Mateoswiatek/TME_Electronics_Project/schemat.brd

## EAGLE design schemat.brd (2024-02-10)

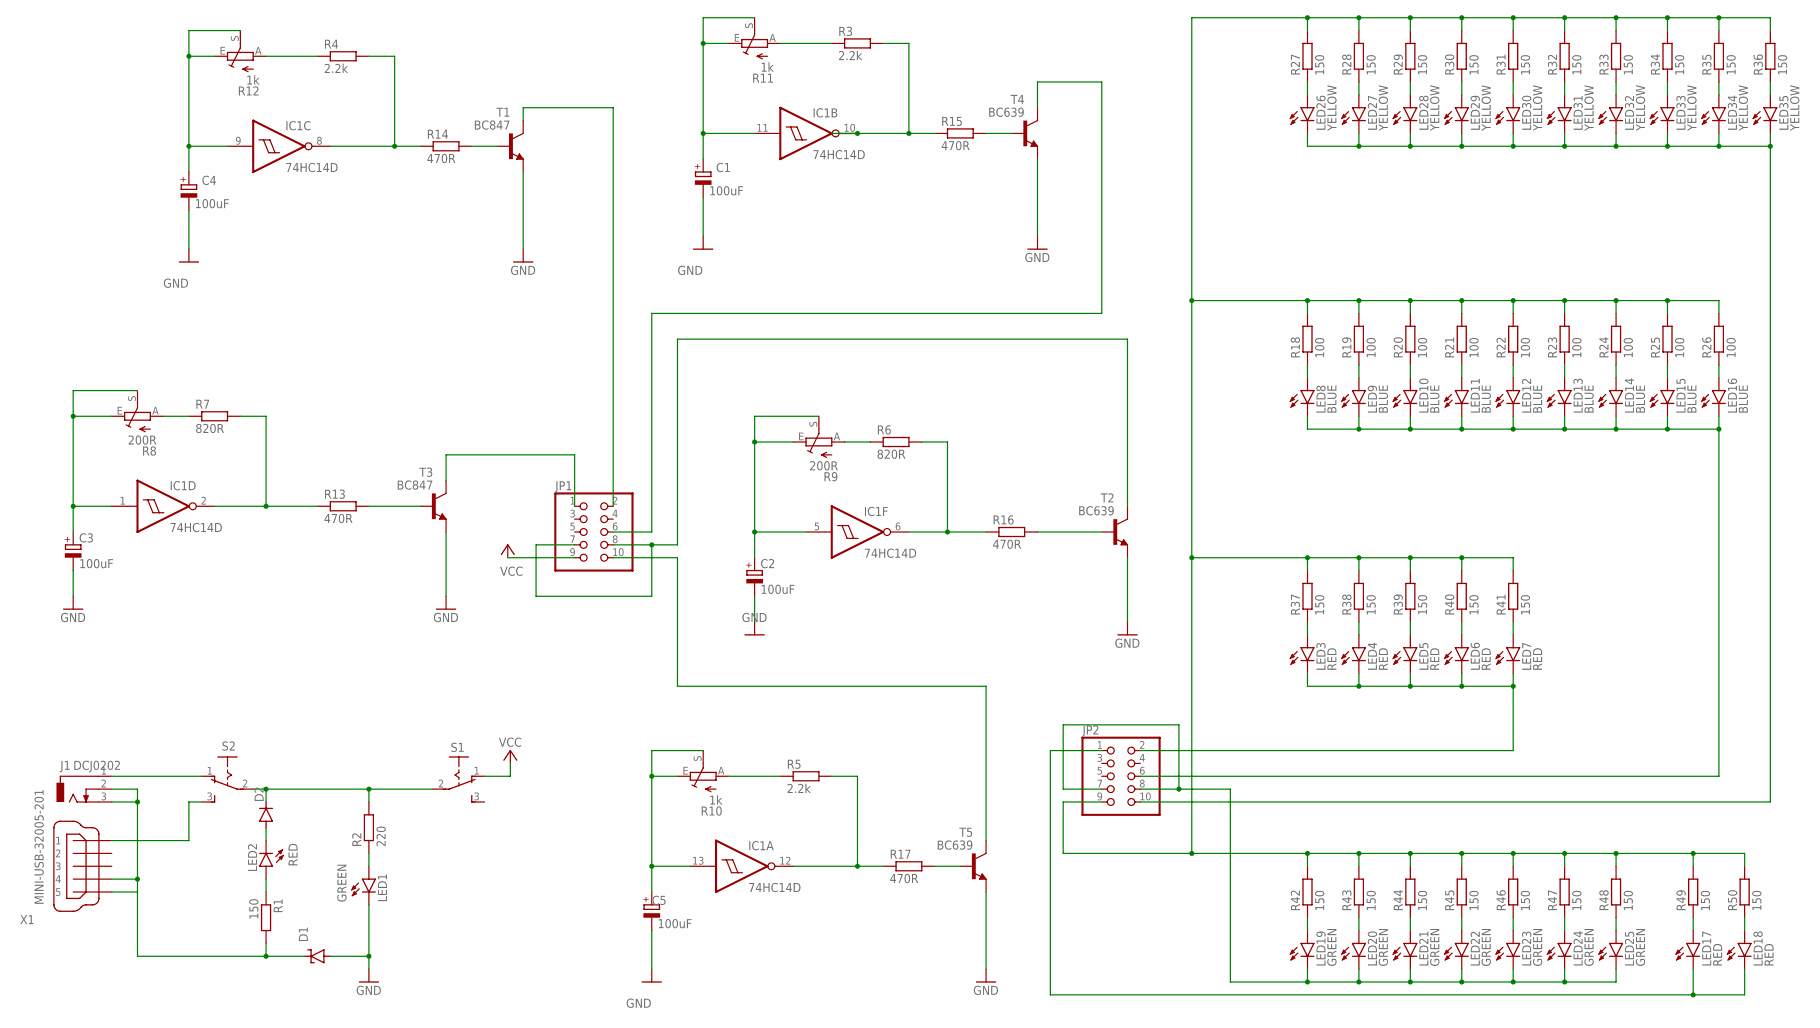
[picture p10: schematic Schemat.sch]

Parts:
C1, C2, C3, C4, C5: 100uF; E2,5-6
D1: SUPPRESSOR-SMBJ; SMBJ
D2: DIODE-DO214AC; DO214AC
IC1: 74HC14D; SO14
J1: DCJ0202
JP1: PINHD-2X5; 2X05
JP2: PINHD-2X5/90; 2X05/90
LED1, LED19, LED20, LED21, LED22, LED23, LED24, LED25: GREEN; LED3MM
LED2, LED3, LED4, LED5, LED6, LED7, LED17, LED18: RED; LED5MM
LED8, LED9, LED10, LED11, LED12, LED13, LED14, LED15, LED16: BLUE; LED5MM
LED26, LED27, LED28, LED29, LED30, LED31, LED32, LED33, LED34, LED35: YELLOW; LED5MM
R1, R27, R28, R29, R30, R31, R32, R33, R34, R35, R36, R37, R38, R39, R40, R41, R42, R43, R44, R45, R46, R47, R48, R49, R50: 150; R0805
R2: 220; R0805
R3, R4, R5: 2.2k; R1206
R6, R7: 820R; R1206
R8, R9: 200R; CA6V
R10, R11, R12: 1k; CA6V
R13, R14, R15, R16, R17: 470R; R1206
R18, R19, R20, R21, R22, R23, R24, R25, R26: 100; R0805
S1, S2: M251
T1, T3: BC847; SOT23
T2, T4, T5: BC639; TO92-ECB
X1: MINI-USB-32005-201; 32005-201

Connections:
GND: C1.-, C2.-, C3.-, C4.-, C5.-, D1.A, IC1.7 (GND), LED1.K (C), T1.2 (E), T2.E, T3.2 (E), T4.E, T5.E
unnamed: JP2.2, LED3.K (C), LED4.K (C), LED5.K (C), LED6.K (C), LED7.K (C)
unnamed: JP2.6, LED8.K (C), LED9.K (C), LED10.K (C), LED11.K (C), LED12.K (C), LED13.K (C), LED14.K (C), LED15.K (C), LED16.K (C)
unnamed: D2.A, LED2.K (C)
unnamed: LED2.A, R1.1
unnamed: JP2.9, R18.2, R19.2, R20.2, R21.2, R22.2, R23.2, R24.2, R25.2, R26.2, R27.2, R28.2, R29.2, R30.2, R31.2, R32.2, R33.2, R34.2, R35.2, R36.2, R37.2, R38.2, R39.2, R40.2, R41.2, R42.2, R43.2, R44.2, R45.2, R46.2, R47.2, R48.2, R49.2, R50.2
unnamed: JP2.10, LED26.K (C), LED27.K (C), LED28.K (C), LED29.K (C), LED30.K (C), LED31.K (C), LED32.K (C), LED33.K (C), LED34.K (C), LED35.K (C)
unnamed: JP2.1, LED17.K (C), LED18.K (C)
unnamed: JP2.7, JP2.8, LED19.K (C), LED20.K (C), LED21.K (C), LED22.K (C), LED23.K (C), LED24.K (C), LED25.K (C)
unnamed: LED3.A, R37.1
unnamed: LED21.A, R44.1
unnamed: LED22.A, R45.1
unnamed: LED23.A, R46.1
unnamed: LED24.A, R47.1
unnamed: LED25.A, R48.1
unnamed: LED19.A, R42.1
unnamed: LED20.A, R43.1
unnamed: LED7.A, R41.1
unnamed: LED6.A, R40.1
unnamed: LED5.A, R39.1
unnamed: LED4.A, R38.1
unnamed: D1.C, J1.2, J1.3, R1.2, X1.4, X1.5
unnamed: LED8.A, R18.1
unnamed: LED9.A, R19.1
unnamed: LED10.A, R20.1
unnamed: LED11.A, R21.1
unnamed: LED12.A, R22.1
unnamed: LED13.A, R23.1
unnamed: LED14.A, R24.1
unnamed: LED15.A, R25.1
unnamed: LED16.A, R26.1
unnamed: JP1.2, T1.3 (C)
unnamed: LED18.A, R50.1
unnamed: LED17.A, R49.1
unnamed: D2.C, R2.2, S1.2, S2.2
unnamed: LED27.A, R28.1
unnamed: LED28.A, R29.1
unnamed: LED29.A, R30.1
unnamed: LED30.A, R31.1
unnamed: LED31.A, R32.1
unnamed: LED32.A, R33.1
unnamed: LED33.A, R34.1
unnamed: LED34.A, R35.1
unnamed: LED35.A, R36.1
unnamed: LED26.A, R27.1
unnamed: C1.+, IC1.11 (I), R11.E, R11.S
unnamed: R3.1, R11.A
unnamed: C4.+, IC1.9 (I), R12.E, R12.S
unnamed: R15.2, T4.B
unnamed: IC1.10 (O), R3.2, R15.1
unnamed: R4.1, R12.A
unnamed: R14.2, T1.1 (B)
unnamed: IC1.8 (O), R4.2, R14.1
unnamed: C5.+, IC1.13 (I), R10.E, R10.S
unnamed: R5.1, R10.A
unnamed: R17.2, T5.B
unnamed: IC1.12 (O), R5.2, R17.1
unnamed: R6.1, R9.A
unnamed: R7.1, R8.A
unnamed: IC1.2 (O), R7.2, R13.1
unnamed: R13.2, T3.1 (B)
unnamed: C3.+, IC1.1 (I), R8.E, R8.S
unnamed: IC1.6 (O), R6.2, R16.1
unnamed: R16.2, T2.B
unnamed: C2.+, IC1.5 (I), R9.E, R9.S
unnamed: LED1.A, R2.1
unnamed: JP1.10, T5.C
unnamed: J1.1, S2.1 (O)
unnamed: S2.3 (S), X1.1
unnamed: JP1.6, T4.C
unnamed: JP1.1, T3.3 (C)
unnamed: JP1.7, JP1.8, T2.C
VCC: IC1.14 (VCC), JP1.9, S1.1 (O)

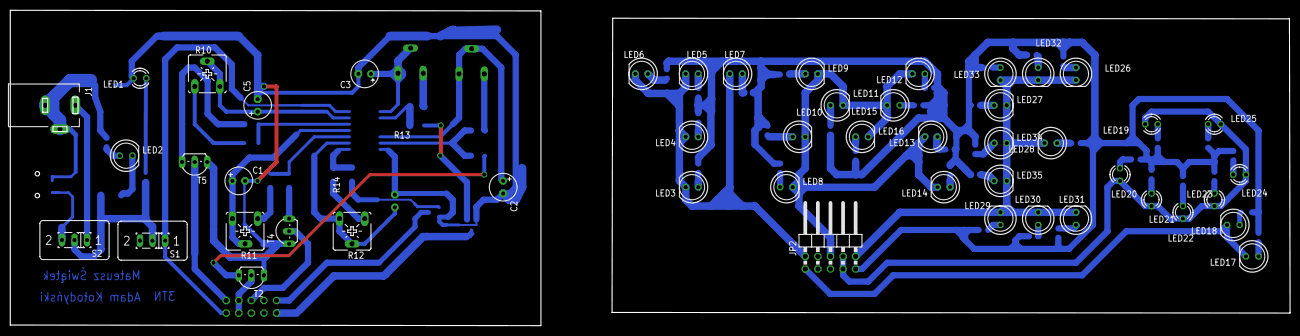
[picture p11: board schemat.brd from above]

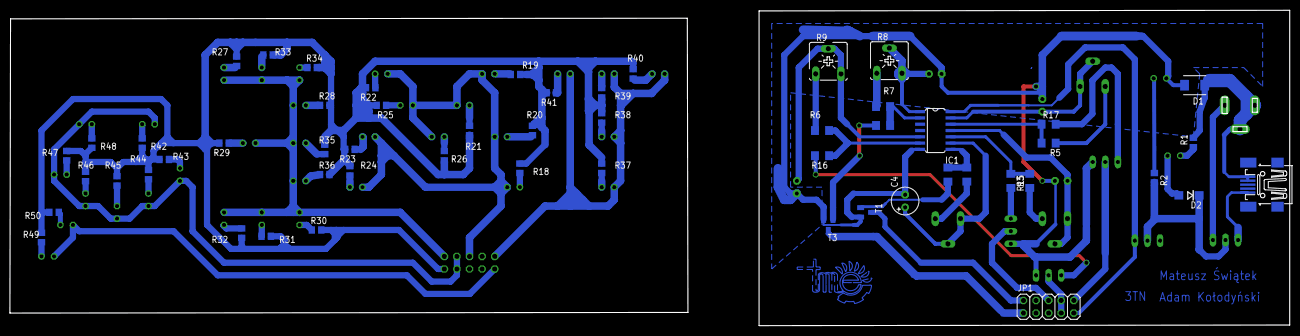
[picture p12: board schemat.brd from below]

Board: 2 copper layers, 258.2 x 63.6 mm, 104 parts (55 on the bottom side), 73 nets.
